Formula-Student-team-Black-Hornets/TempSens/hardware/TempSens.kicad_sch

## KiCad design hardware/TempSens.kicad_sch (2026-06-15)

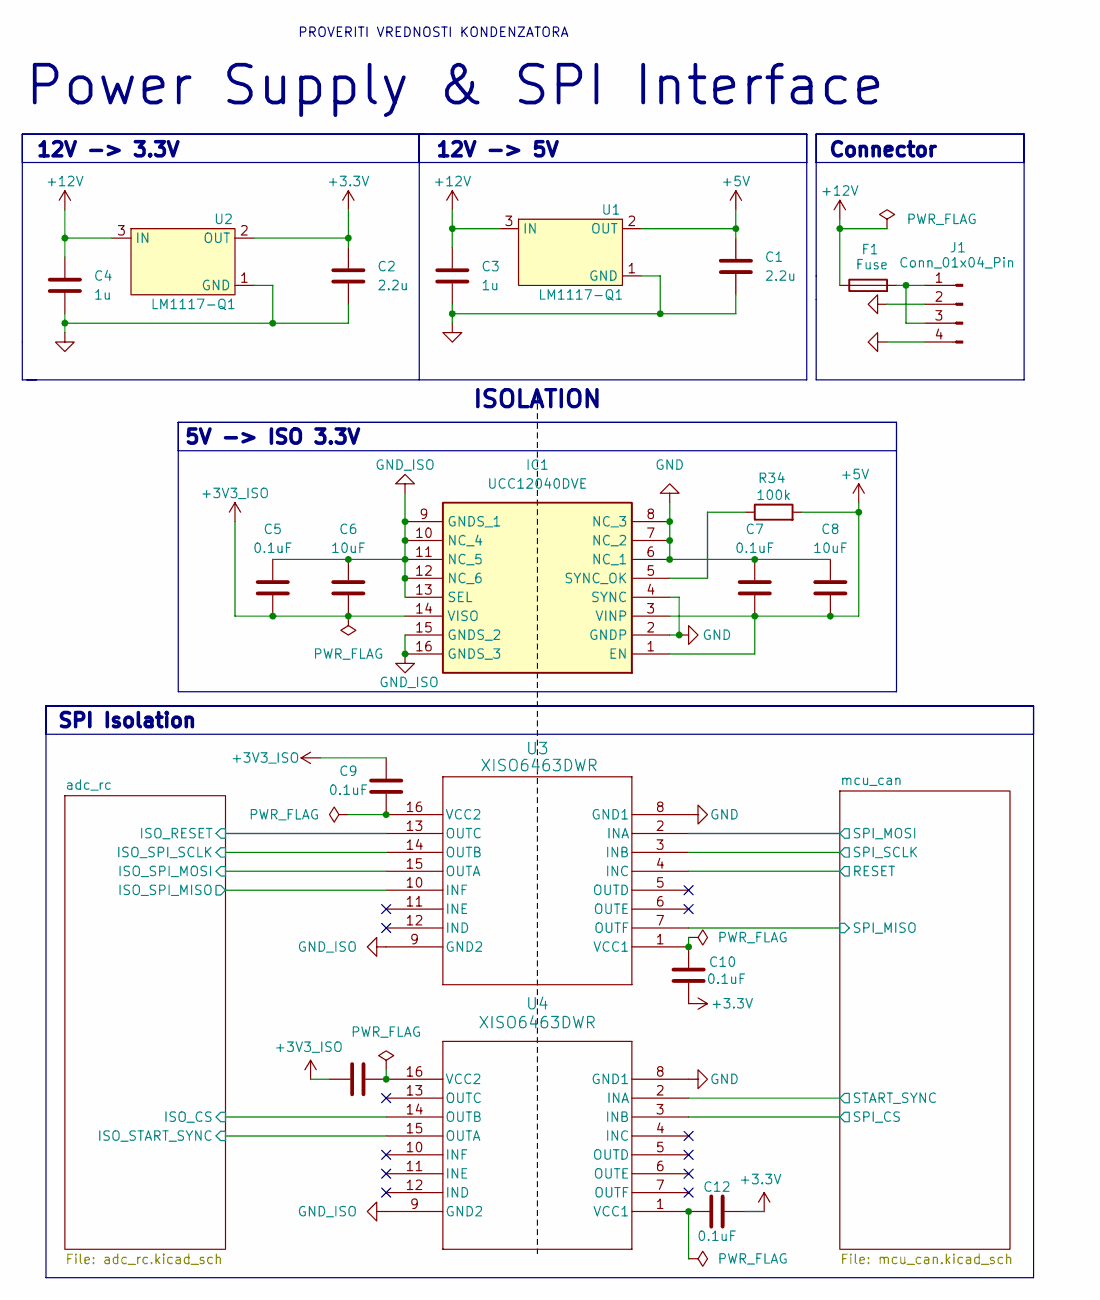
[picture p7: schematic TempSens.kicad_sch]

Parts:
C1, C2: 2.2u; C_0603_1608Metric
C3, C4: 1u; C_0603_1608Metric
C5, C7, C9, C10, C11, C12: 0.1uF
C6, C8: 10uF
F1: Fuse
IC1: UCC12040DVE; SOIC127P1030X265-16N; Mouser Part Number 595-UCC12040DVE
J1: Conn_01x04_Pin
R34: 100k
U1, U2: LM1117-Q1; SOT-223-3_TabPin2
U3, U4: XISO6463DWR; SOIC_DW_16L_TEX

Connections:
+3.3V: C2.1, C10.2, C12.2, U2.2 (OUT)
+3V3_ISO: C5.1, C6.1, C9.2, C11.2, IC1.14 (VISO)
+5V: C1.1, C7.1, C8.1, IC1.1 (EN), IC1.3 (VINP), R34.2, U1.2 (OUT)
+12V: C3.1, C4.1, F1.1, U1.3 (IN), U2.3 (IN)
GND: C1.2, C2.2, C3.2, C4.2, C7.2, C8.2, IC1.2 (GNDP), IC1.4 (SYNC), IC1.6 (NC_1), IC1.7 (NC_2), IC1.8 (NC_3), J1.2, J1.4, U1.1 (GND), U2.1 (GND), U3.8 (GND1), U4.8 (GND1)
GND_ISO: C5.2, C6.2, IC1.9 (GNDS_1), IC1.10 (NC_4), IC1.11 (NC_5), IC1.12 (NC_6), IC1.13 (SEL), IC1.15 (GNDS_2), IC1.16 (GNDS_3), U3.9 (GND2), U4.9 (GND2)
ISO_CS: U4.14 (OUTB)
ISO_RESET: U3.13 (OUTC)
ISO_SPI_MISO: U3.10 (INF)
ISO_SPI_MOSI: U3.15 (OUTA)
ISO_SPI_SCLK: U3.14 (OUTB)
ISO_START_SYNC: U4.15 (OUTA)
unnamed: C9.1, U3.16 (VCC2)
unnamed: C10.1, U3.1 (VCC1)
unnamed: C11.1, U4.16 (VCC2)
unnamed: C12.1, U4.1 (VCC1)
unnamed: F1.2, J1.1, J1.3
unnamed: IC1.5 (SYNC_OK), R34.1
RESET: U3.4 (INC)
SPI_CS: U4.3 (INB)
SPI_MISO: U3.7 (OUTF)
SPI_MOSI: U3.2 (INA)
SPI_SCLK: U3.3 (INB)
START_SYNC: U4.2 (INA)

Notes on the sheet:
12V -> 5V
PROVERITI VREDNOSTI KONDENZATORA
ISOLATION
5V -> ISO 3.3V
Connector
12V -> 3.3V
SPI Isolation
Power Supply & SPI Interface
