Formula-Student-team-Black-Hornets/TempSens/hardware/adc_rc.kicad_sch

## KiCad design hardware/adc_rc.kicad_sch (2026-06-15)

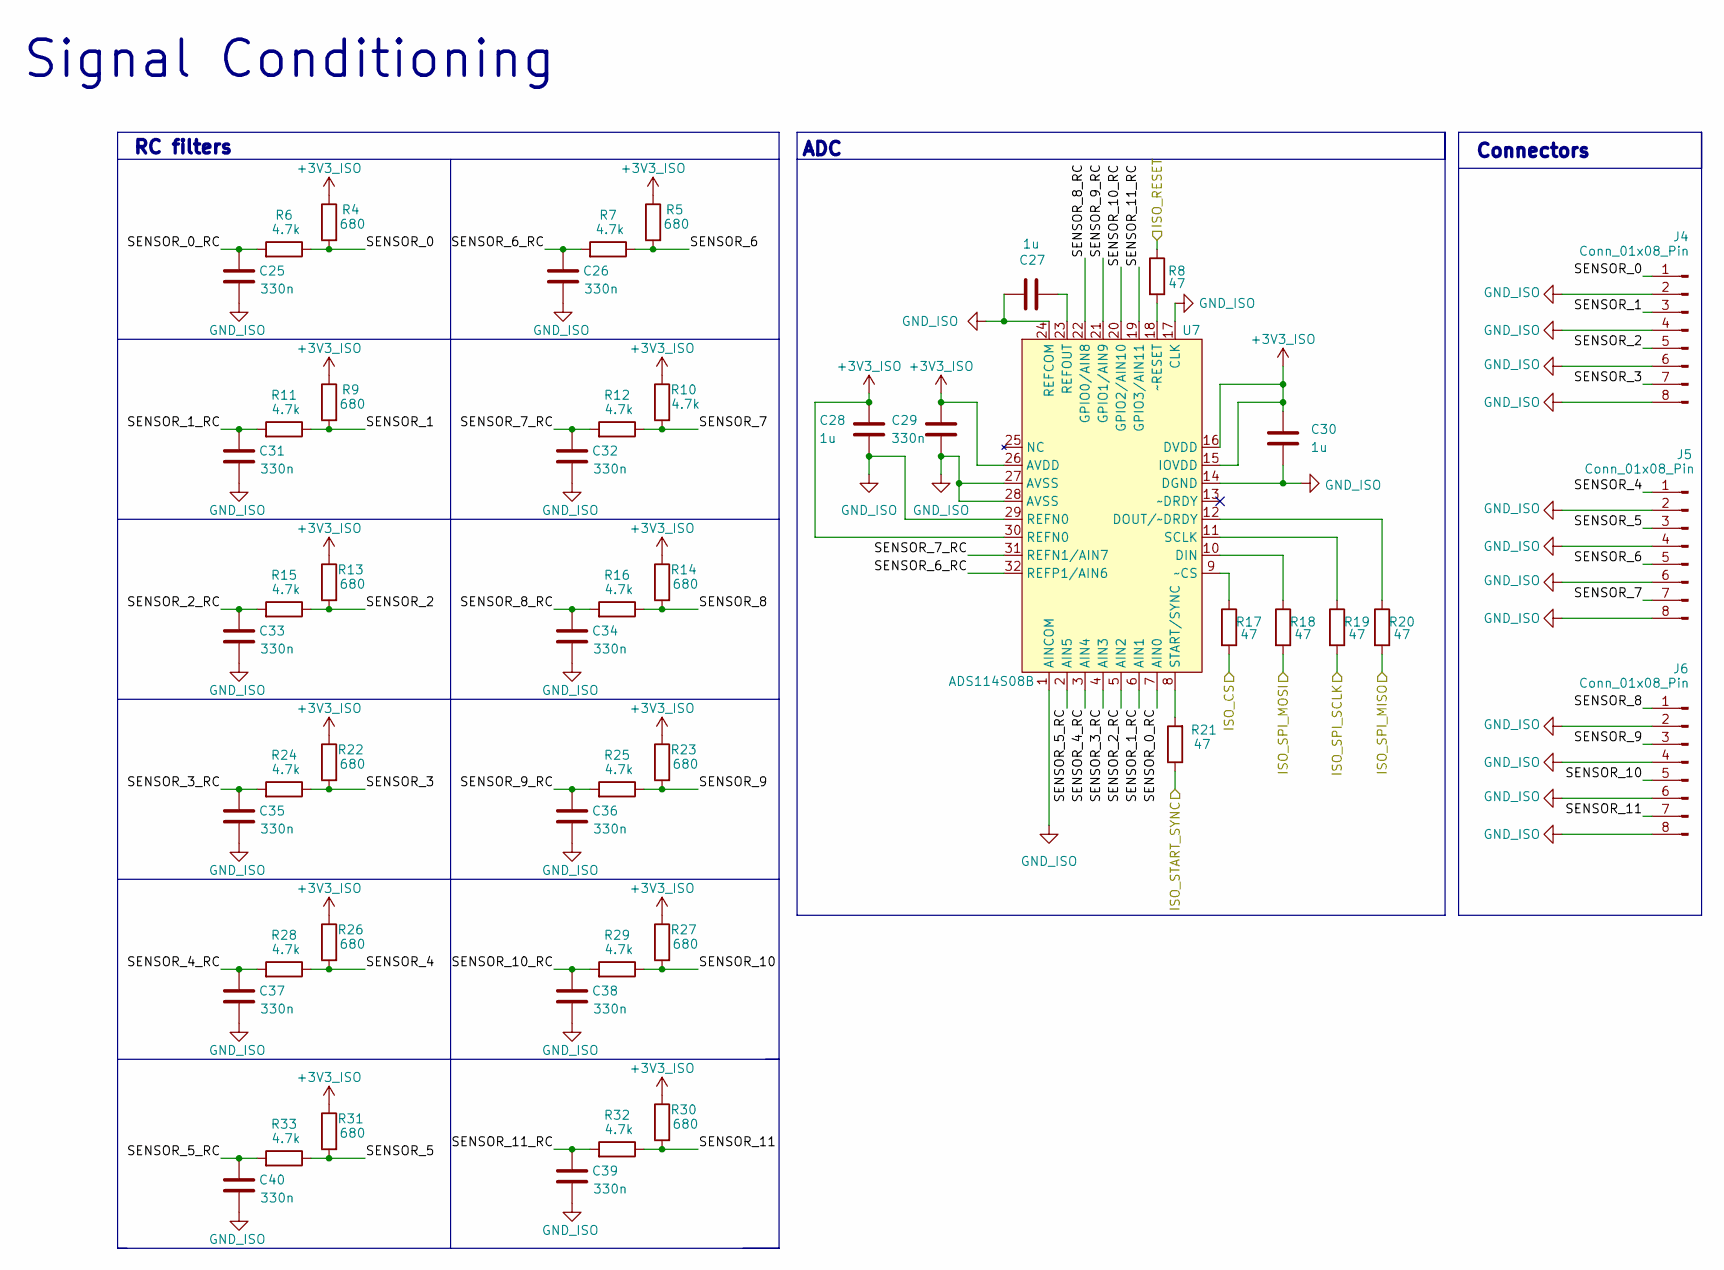
[picture p8: schematic adc_rc.kicad_sch]

Parts:
C25, C26, C29, C31, C32, C33, C34, C35, C36, C37, C38, C39, C40: 330n; C_0402_1005Metric
C27, C28, C30: 1u; C_0402_1005Metric
J4, J5, J6: Conn_01x08_Pin
R4, R5, R9, R13, R14, R22, R23, R26, R27, R30, R31: 680; R_0402_1005Metric
R6, R7, R10, R11, R12, R15, R16, R24, R25, R28, R29, R32, R33: 4.7k; R_0402_1005Metric
R8, R17, R18, R19, R20, R21: 47; R_0402_1005Metric
U7: ADS114S08B; TQFP-32_7x7mm_P0.8mm

Connections:
+3V3_ISO: C28.1, C29.1, C30.1, R4.1, R5.1, R9.1, R10.1, R13.1, R14.1, R22.1, R23.1, R26.1, R27.1, R30.1, R31.1, U7.15 (IOVDD), U7.16 (DVDD), U7.26 (AVDD), U7.30 (REFN0)
GND_ISO: C25.2, C26.2, C27.2, C28.2, C29.2, C30.2, C31.2, C32.2, C33.2, C34.2, C35.2, C36.2, C37.2, C38.2, C39.2, C40.2, J4.2, J4.4, J4.6, J4.8, J5.2, J5.4, J5.6, J5.8, J6.2, J6.4, J6.6, J6.8, U7.1 (AINCOM), U7.14 (DGND), U7.17 (CLK), U7.24 (REFCOM), U7.27 (AVSS), U7.28 (AVSS), U7.29 (REFN0)
ISO_CS: R17.2
ISO_RESET: R8.1
ISO_SPI_MISO: R20.2
ISO_SPI_MOSI: R18.2
ISO_SPI_SCLK: R19.2
ISO_START_SYNC: R21.1
unnamed: C27.1, U7.23 (REFOUT)
unnamed: R8.2, U7.18 (~RESET)
unnamed: R17.1, U7.9 (~CS)
unnamed: R18.1, U7.10 (DIN)
unnamed: R19.1, U7.11 (SCLK)
unnamed: R20.1, U7.12 (DOUT/~DRDY)
unnamed: R21.2, U7.8 (START/SYNC)
SENSOR_0: J4.1, R4.2, R6.1
SENSOR_0_RC: C25.1, R6.2, U7.7 (AIN0)
SENSOR_1: J4.3, R9.2, R11.1
SENSOR_1_RC: C31.1, R11.2, U7.6 (AIN1)
SENSOR_2: J4.5, R13.2, R15.1
SENSOR_2_RC: C33.1, R15.2, U7.5 (AIN2)
SENSOR_3: J4.7, R22.2, R24.1
SENSOR_3_RC: C35.1, R24.2, U7.4 (AIN3)
SENSOR_4: J5.1, R26.2, R28.1
SENSOR_4_RC: C37.1, R28.2, U7.3 (AIN4)
SENSOR_5: J5.3, R31.2, R33.1
SENSOR_5_RC: C40.1, R33.2, U7.2 (AIN5)
SENSOR_6: J5.5, R5.2, R7.1
SENSOR_6_RC: C26.1, R7.2, U7.32 (REFP1/AIN6)
SENSOR_7: J5.7, R10.2, R12.1
SENSOR_7_RC: C32.1, R12.2, U7.31 (REFN1/AIN7)
SENSOR_8: J6.1, R14.2, R16.1
SENSOR_8_RC: C34.1, R16.2, U7.22 (GPIO0/AIN8)
SENSOR_9: J6.3, R23.2, R25.1
SENSOR_9_RC: C36.1, R25.2, U7.21 (GPIO1/AIN9)
SENSOR_10: J6.5, R27.2, R29.1
SENSOR_10_RC: C38.1, R29.2, U7.20 (GPIO2/AIN10)
SENSOR_11: J6.7, R30.2, R32.1
SENSOR_11_RC: C39.1, R32.2, U7.19 (GPIO3/AIN11)

Notes on the sheet:
RC filters
ADC
Connectors
Signal Conditioning
