Formula-Student-team-Black-Hornets/TempSens/hardware/mcu_can.kicad_sch

## KiCad design hardware/mcu_can.kicad_sch (2026-06-15)

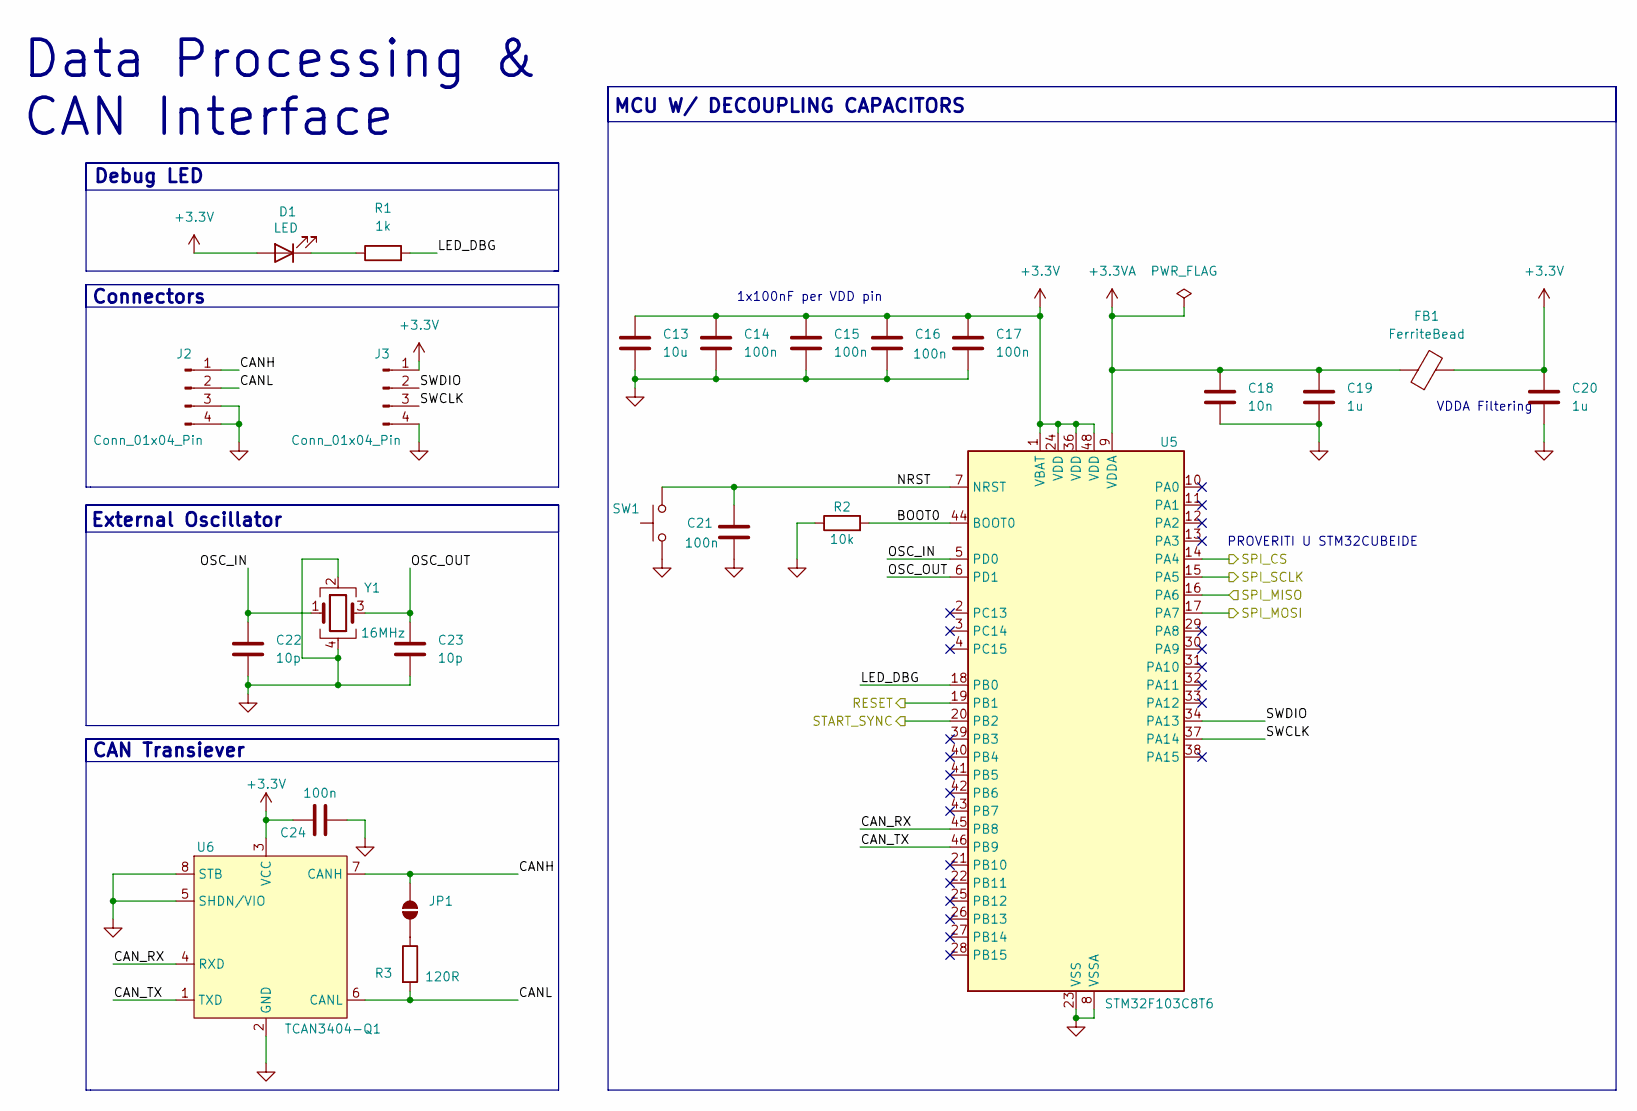
[picture p9: schematic mcu_can.kicad_sch]

Parts:
C13: 10u; C_0603_1608Metric
C14, C15, C16, C17, C21: 100n; C_0402_1005Metric
C18: 10n; C_0402_1005Metric
C19, C20: 1u; C_0402_1005Metric
C22, C23: 10p; C_0402_1005Metric
C24: 100n; C_0603_1608Metric
D1: LED; LED_0603_1608Metric
FB1: FerriteBead; L_0603_1608Metric
J2, J3: Conn_01x04_Pin; PinHeader_1x04_P2.54mm_Vertical
JP1: SolderJumper_2_Open
R1: 1k; R_0402_1005Metric
R2: 10k; R_0402_1005Metric
R3: 120R; R_0402_1005Metric
SW1: SW_MEC_5G; SW_SPST_B3U-1000P
U5: STM32F103C8T6; LQFP-48_7x7mm_P0.5mm
U6: TCAN3404-Q1; SOIC-8-1EP_3.9x4.9mm_P1.27mm_EP2.95x4.9mm_Mask2.71x3.4mm
Y1: 16MHz; Crystal_SMD_3225-4Pin_3.2x2.5mm

Connections:
+3.3V: C13.1, C14.1, C15.1, C16.1, C17.1, C20.1, C24.1, D1.2 (A), FB1.2, J3.1, U5.1 (VBAT), U5.24 (VDD), U5.36 (VDD), U5.48 (VDD), U6.3 (VCC)
+3.3VA: C18.1, C19.1, FB1.1, U5.9 (VDDA)
BOOT0: R2.2, U5.44 (BOOT0)
CANH: J2.1, JP1.2 (B), U6.7 (CANH)
CANL: J2.2, R3.2, U6.6 (CANL)
CAN_RX: U5.45 (PB8), U6.4 (RXD)
CAN_TX: U5.46 (PB9), U6.1 (TXD)
GND: C13.2, C14.2, C15.2, C16.2, C17.2, C18.2, C19.2, C20.2, C21.2, C22.2, C23.2, C24.2, J2.3, J2.4, J3.4, R2.1, SW1.1 (A), SW1.2 (A), U5.8 (VSSA), U5.23 (VSS), U5.35 (VSS), U5.47 (VSS), U6.2 (GND), U6.5 (SHDN/VIO), U6.8 (STB), Y1.2, Y1.4
LED_DBG: R1.2, U5.18 (PB0)
NRST: C21.1, SW1.3 (B), SW1.4 (B), U5.7 (NRST)
unnamed: D1.1 (K), R1.1
unnamed: JP1.1 (A), R3.1
OSC_IN: C22.1, U5.5 (PD0), Y1.1
OSC_OUT: C23.1, U5.6 (PD1), Y1.3
RESET: U5.19 (PB1)
SPI_CS: U5.14 (PA4)
SPI_MISO: U5.16 (PA6)
SPI_MOSI: U5.17 (PA7)
SPI_SCLK: U5.15 (PA5)
START_SYNC: U5.20 (PB2)
SWCLK: J3.3, U5.37 (PA14)
SWDIO: J3.2, U5.34 (PA13)

Notes on the sheet:
1x100nF per VDD pin
VDDA Filtering
Data Processing & CAN Interface
Debug LED
PROVERITI U STM32CUBEIDE
Connectors
CAN Transiever
External Oscillator
MCU W/ DECOUPLING CAPACITORS
